pozsarzs/mm9a/pictures/mm9a.jpg

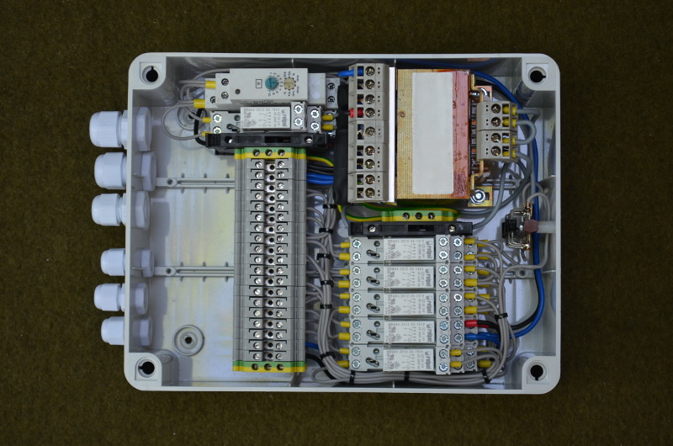
pictures/mm9a.jpg
