pozsarzs/mm9a/README.md

**MM9A * Irrigation controller for MM8D**  
Copyright (C) 2022 Pozsár Zsolt <pozsarzs@gmail.com>  
Homepage: <http://www.pozsarzs.hu>  
GitHub: <https://github.com/pozsarzs/mm9a>

**Documentation**

- version:             1.0
- language:            en
- licence:             CC-BY-NC-4.0

**Hardware**

 - version:            v220111
