pozsarzs/mm9a/documents/sch_mm9a.pdf

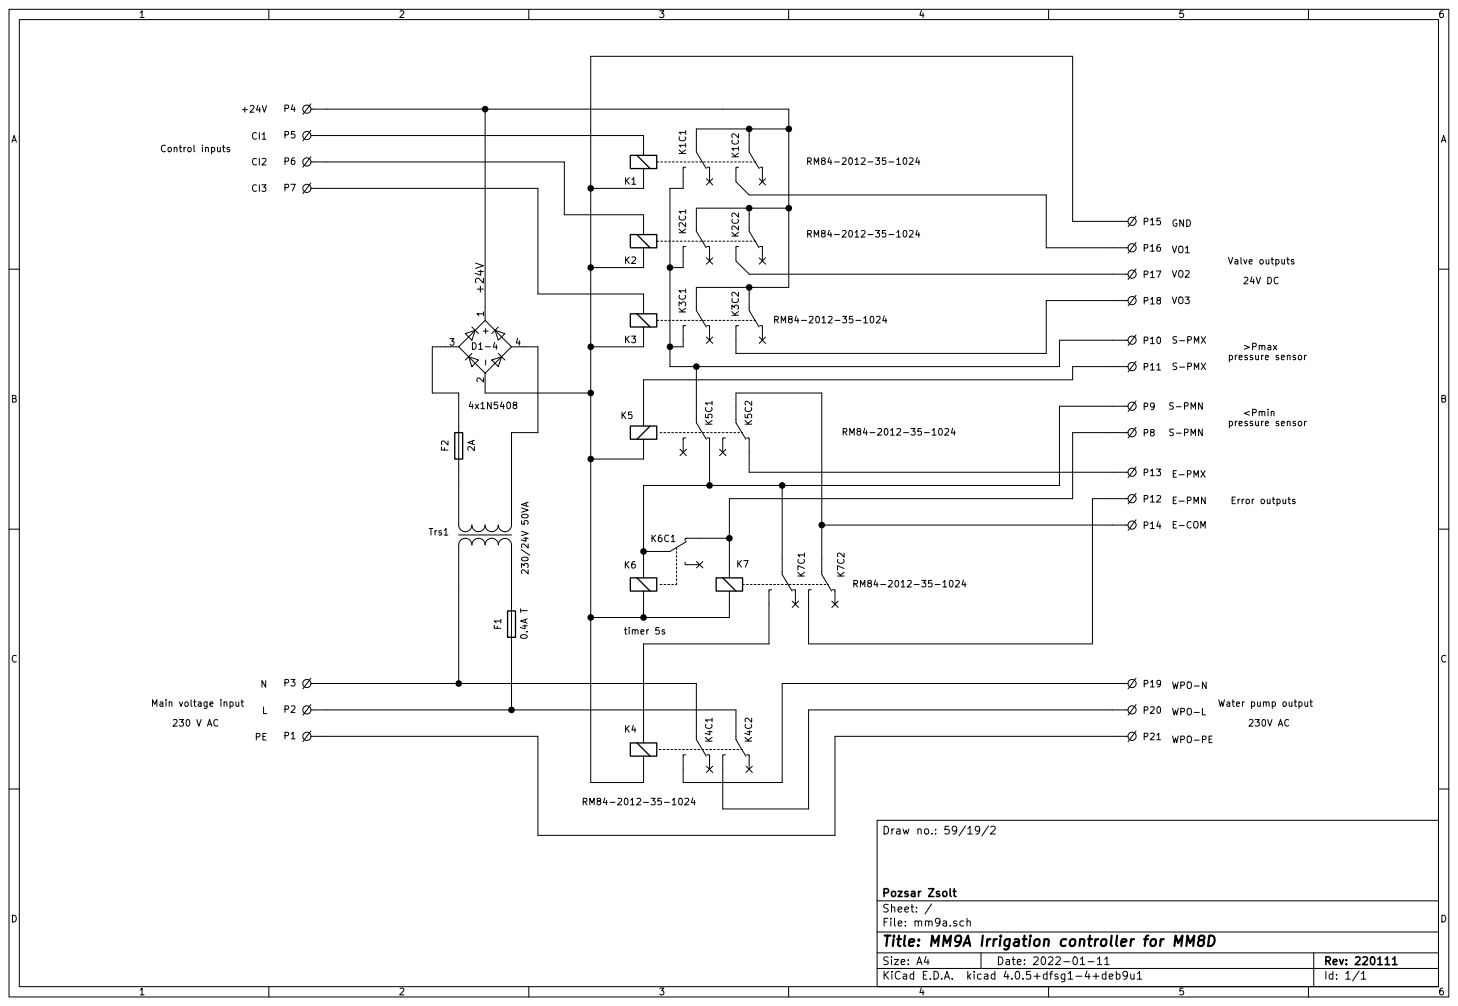
[picture p4: page 1]

LPE Main voltage input

File: mm9a.sch Sheet: / Pozsar Zsolt Draw no.: 59/19/2

Id: 1/1 Title: MM9A Irrigation controller for MM8D
