pozsarzs/mm9a/cad_files/mm9a.sch

## KiCad design cad_files/mm9a.sch (2022-05-12)

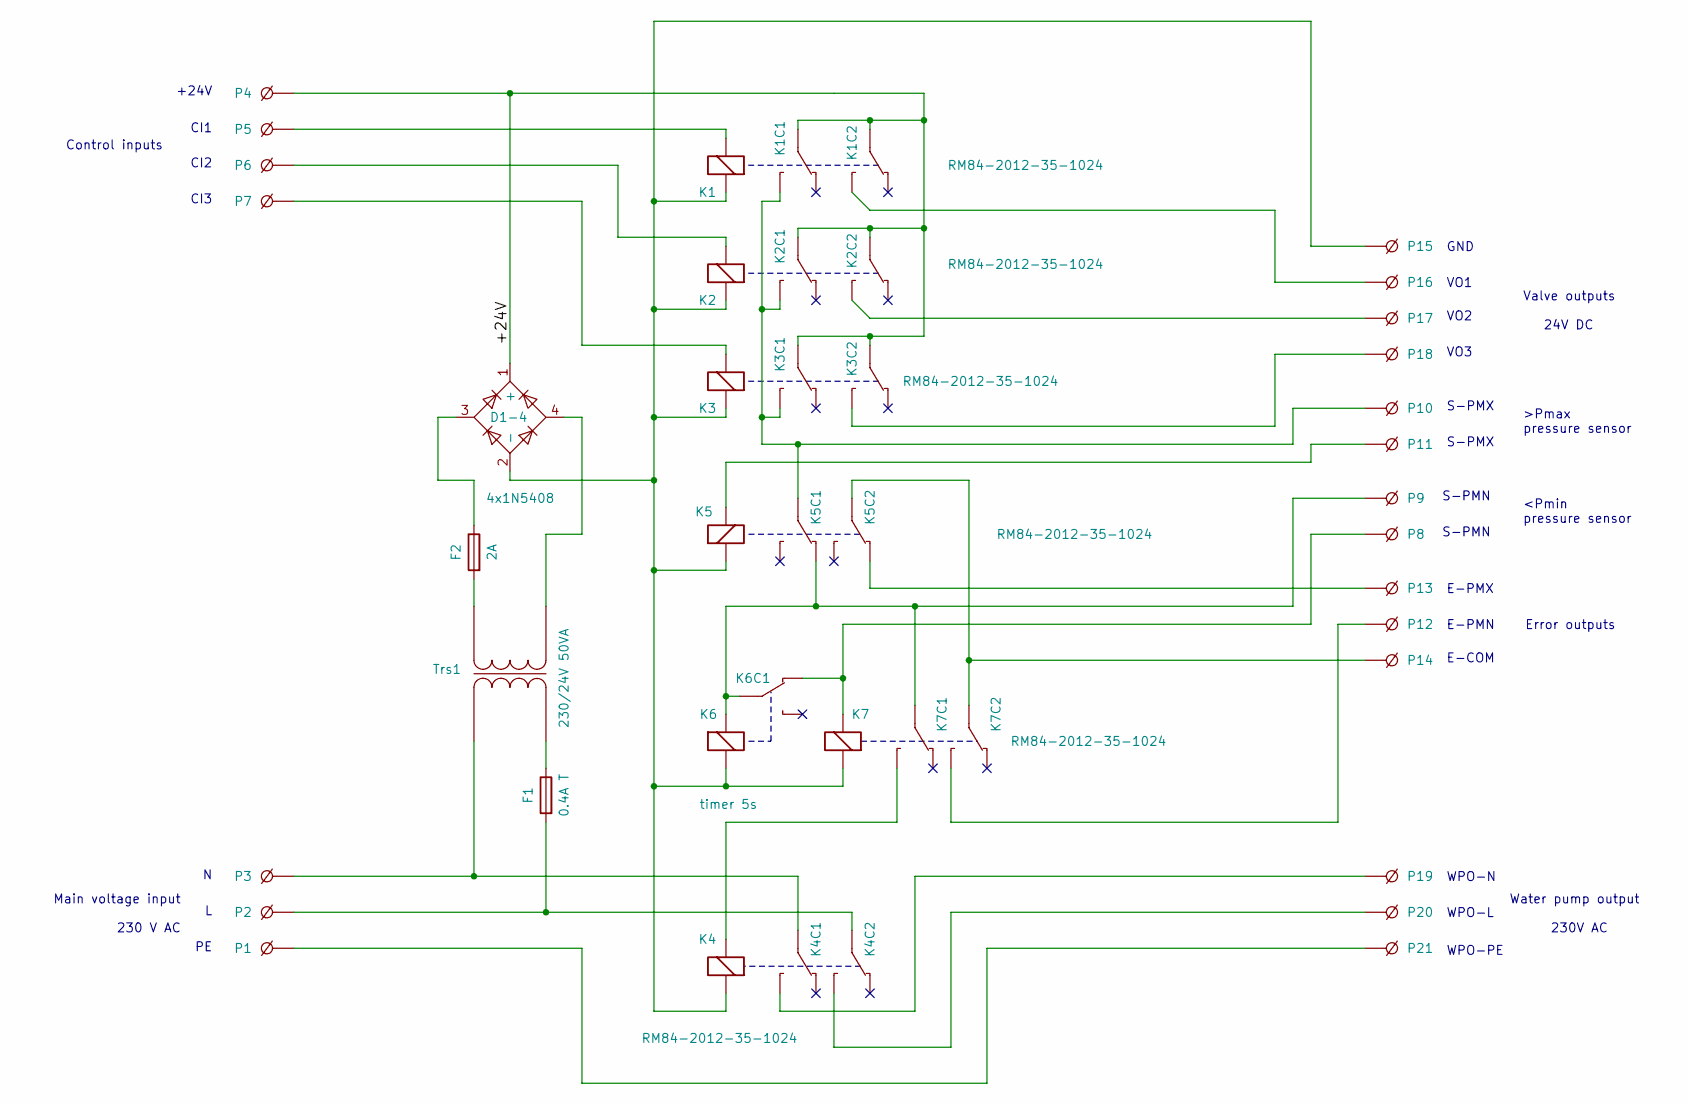
[picture p5: schematic mm9a.sch]

Parts:
D1-4: 4x1N5408
F1: 0.4A T
F2: 2A
K1, K2, K3, K4, K5, K7: RM84-2012-35-1024
K1C1, K1C2, K2C1, K2C2, K3C1, K3C2, K4C1, K4C2, K5C1, K5C2, K6C1, K7C1, K7C2: auxcontalt
K6: timer 5s
P1, P2, P3, P4, P5, P6, P7, P8, P9, P10, P11, P12, P13, P14, P15, P16, P17, P18, P19, P20, P21: screw_conn
Trs1: 230/24V 50VA

Connections:
+24V: D1-4.1 (+), K1C1.~, K1C2.~, K2C1.~, K2C2.~, K3C1.~, K3C2.~, P4.1
unnamed: D1-4.2 (-), K1.1 (-), K2.1 (-), K3.1 (-), K4.1 (-), K5.1 (-), K6.2 (+), K7.1 (-), P15.1
unnamed: D1-4.3, F2.1
unnamed: D1-4.4, Trs1.~
unnamed: F1.1, Trs1.~
unnamed: F1.2, K4C2.~, P2.1
unnamed: F2.2, Trs1.~
unnamed: K1.2 (+), P5.1
unnamed: K1C1.~, K2C1.~, K3C1.~, K5C1.~, P10.1
unnamed: K1C2.~, P16.1
unnamed: K2.2 (+), P6.1
unnamed: K2C2.~, P17.1
unnamed: K3.2 (+), P7.1
unnamed: K3C2.~, P18.1
unnamed: K4.2 (+), K7C1.~
unnamed: K4C1.~, P3.1, P19.1, Trs1.~
unnamed: K4C2.~, P20.1
unnamed: K5.2 (+), P11.1
unnamed: K5C1.~, K6.1 (-), K6C1.~, K7C1.~, P9.1
unnamed: K5C2.~, K7C2.~, P13.1, P14.1
unnamed: K6C1.~, K7.2 (+), P8.1
unnamed: K7C2.~, P12.1
unnamed: P1.1, P21.1

Notes on the sheet:
WPO-L
GND
VO1
WPO-N
WPO-PE
E-PMN
E-PMX
CI1
+24V
Main voltage input 230 V AC
CI2
CI3
E-COM
VO2
VO3
Water pump output 230V AC
Valve outputs 24V DC
Error outputs
>Pmax pressure sensor
<Pmin pressure sensor
Control inputs
S-PMX
S-PMN
